hamster/TubeCube/TubeCube.pdf

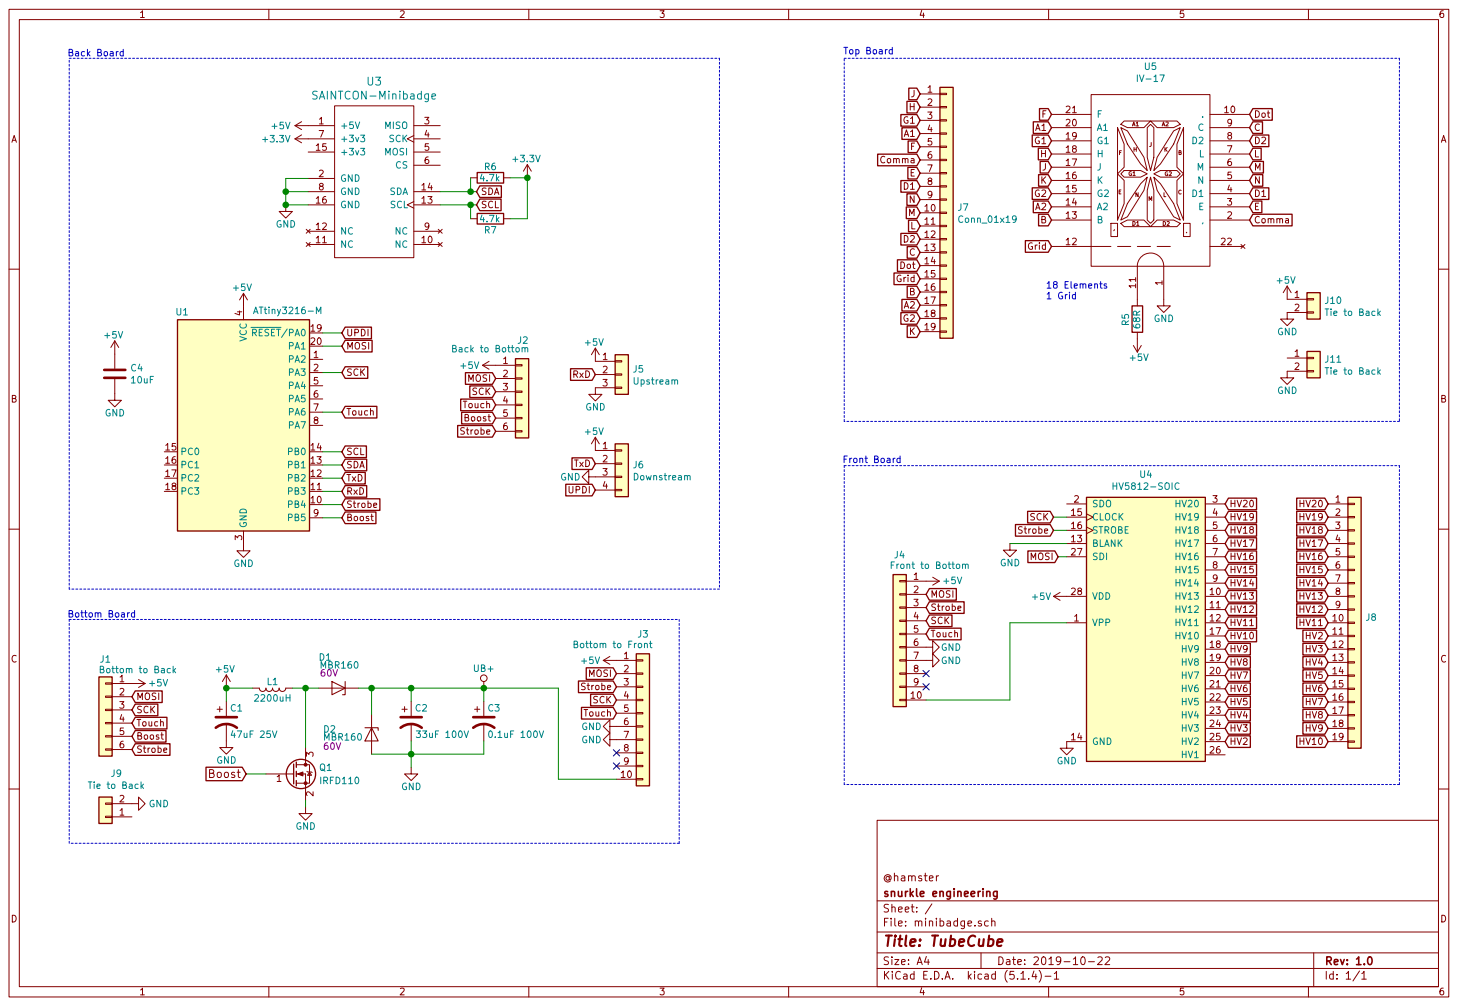
[picture p3: page 1]

18 Elements 1 Grid Back Board

J7Conn_01x19 GND GND GND GND 12

Front Board Bottom Board

@hamster
File: minibadge.sch Sheet: / snurkle engineering
