hamster/TubeCube/Software/TubeCube/TubeCube/src/driver_init.c

/**
 * \file
 *
 * \brief Driver initialization.
 *
 (c) 2018 Microchip Technology Inc. and its subsidiaries.

    Subject to your compliance with these terms,you may use this software and
    any derivatives exclusively with Microchip products.It is your responsibility
    to comply with third party license terms applicable to your use of third party
    software (including open source software) that may accompany Microchip software.

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
    IN NO EVENT WILL MICROCHIP BE LIABLE FOR ANY INDIRECT, SPECIAL, PUNITIVE,
    INCIDENTAL OR CONSEQUENTIAL LOSS, DAMAGE, COST OR EXPENSE OF ANY KIND
    WHATSOEVER RELATED TO THE SOFTWARE, HOWEVER CAUSED, EVEN IF MICROCHIP HAS
    BEEN ADVISED OF THE POSSIBILITY OR THE DAMAGES ARE FORESEEABLE. TO THE
    FULLEST EXTENT ALLOWED BY LAW, MICROCHIP'S TOTAL LIABILITY ON ALL CLAIMS IN
    ANY WAY RELATED TO THIS SOFTWARE WILL NOT EXCEED THE AMOUNT OF FEES, IF ANY,
    THAT YOU HAVE PAID DIRECTLY TO MICROCHIP FOR THIS SOFTWARE.
 *
 */

/*
 * Code generated by START.
 *
 * This file will be overwritten when reconfiguring your START project.
 * Please copy examples or other code you want to keep to a separate file
 * to avoid losing it when reconfiguring.
 */

#include "driver_init.h"
#include <system.h>

/* configure the pins and initialize the registers */
void USART_0_initialization(void)
{

	// Set pin direction to input
	PB3_set_dir(PORT_DIR_IN);

	PB3_set_pull_mode(
	    // <y> Pull configuration
	    // <id> pad_pull_config
	    // <PORT_PULL_OFF"> Off
	    // <PORT_PULL_UP"> Pull-up
	    PORT_PULL_OFF);

	// Set pin direction to output
	PB2_set_dir(PORT_DIR_OUT);

	PB2_set_level(
	    // <y> Initial level
	    // <id> pad_initial_level
	    // <false"> Low
	    // <true"> High
	    false);

	USART_0_init();
}

void PWM_0_initialization(void)
{

	// Set pin direction to output
	Boost_set_dir(PORT_DIR_OUT);

	Boost_set_level(
	    // <y> Initial level
	    // <id> pad_initial_level
	    // <false"> Low
	    // <true"> High
	    false);

	/* set the alternate pin mux */
	PORTMUX.CTRLC |= PORTMUX_TCA02_bm;

	PWM_0_init();
}

/* configure the pins and initialize the registers */
void SPI_0_initialization(void)
{

	// Set pin direction to input
	PA2_set_dir(PORT_DIR_IN);

	PA2_set_pull_mode(
	    // <y> Pull configuration
	    // <id> pad_pull_config
	    // <PORT_PULL_OFF"> Off
	    // <PORT_PULL_UP"> Pull-up
	    PORT_PULL_OFF);

	// Set pin direction to output
	PA1_set_dir(PORT_DIR_OUT);

	PA1_set_level(
	    // <y> Initial level
	    // <id> pad_initial_level
	    // <false"> Low
	    // <true"> High
	    false);

	// Set pin direction to output
	PA3_set_dir(PORT_DIR_OUT);

	PA3_set_level(
	    // <y> Initial level
	    // <id> pad_initial_level
	    // <false"> Low
	    // <true"> High
	    false);

	SPI_0_init();
}

/* configure pins and initialize registers */
void I2C_0_initialization(void)
{

	PB0_set_dir(
	    // <y> Pin direction
	    // <id> pad_dir
	    // <PORT_DIR_OFF"> Off
	    // <PORT_DIR_IN"> In
	    // <PORT_DIR_OUT"> Out
	    PORT_DIR_OUT);

	PB0_set_level(
	    // <y> Initial level
	    // <id> pad_initial_level
	    // <false"> Low
	    // <true"> High
	    false);

	PB0_set_pull_mode(
	    // <y> Pull configuration
	    // <id> pad_pull_config
	    // <PORT_PULL_OFF"> Off
	    // <PORT_PULL_UP"> Pull-up
	    PORT_PULL_OFF);

	PB0_set_inverted(
	    // <y> Invert I/O on pin
	    // <id> pad_invert
	    // <false"> Not inverted
	    // <true"> Inverted
	    false);

	PB0_set_isc(
	    // <y> Pin Input/Sense Configuration
	    // <id> pad_isc
	    // <PORT_ISC_INTDISABLE_gc"> Interrupt disabled but input buffer enabled
	    // <PORT_ISC_BOTHEDGES_gc"> Sense Both Edges
	    // <PORT_ISC_RISING_gc"> Sense Rising Edge
	    // <PORT_ISC_FALLING_gc"> Sense Falling Edge
	    // <PORT_ISC_INPUT_DISABLE_gc"> Digital Input Buffer disabled
	    // <PORT_ISC_LEVEL_gc"> Sense low Level
	    PORT_ISC_INTDISABLE_gc);

	PB1_set_dir(
	    // <y> Pin direction
	    // <id> pad_dir
	    // <PORT_DIR_OFF"> Off
	    // <PORT_DIR_IN"> In
	    // <PORT_DIR_OUT"> Out
	    PORT_DIR_OUT);

	PB1_set_level(
	    // <y> Initial level
	    // <id> pad_initial_level
	    // <false"> Low
	    // <true"> High
	    false);

	PB1_set_pull_mode(
	    // <y> Pull configuration
	    // <id> pad_pull_config
	    // <PORT_PULL_OFF"> Off
	    // <PORT_PULL_UP"> Pull-up
	    PORT_PULL_OFF);

	PB1_set_inverted(
	    // <y> Invert I/O on pin
	    // <id> pad_invert
	    // <false"> Not inverted
	    // <true"> Inverted
	    false);

	PB1_set_isc(
	    // <y> Pin Input/Sense Configuration
	    // <id> pad_isc
	    // <PORT_ISC_INTDISABLE_gc"> Interrupt disabled but input buffer enabled
	    // <PORT_ISC_BOTHEDGES_gc"> Sense Both Edges
	    // <PORT_ISC_RISING_gc"> Sense Rising Edge
	    // <PORT_ISC_FALLING_gc"> Sense Falling Edge
	    // <PORT_ISC_INPUT_DISABLE_gc"> Digital Input Buffer disabled
	    // <PORT_ISC_LEVEL_gc"> Sense low Level
	    PORT_ISC_INTDISABLE_gc);

	I2C_0_init();
}

/**
 * \brief System initialization
 */
void system_init()
{
	mcu_init();

	/* PORT setting on PB4 */

	// Set pin direction to output
	Strobe_set_dir(PORT_DIR_OUT);

	Strobe_set_level(
	    // <y> Initial level
	    // <id> pad_initial_level
	    // <false"> Low
	    // <true"> High
	    false);

	CLKCTRL_init();

	USART_0_initialization();

	PWM_0_initialization();

	SPI_0_initialization();

	CPUINT_init();

	SLPCTRL_init();

	I2C_0_initialization();

	BOD_init();
}
