hamster/TubeCube/Software/TubeCube/TubeCube/characters.h

/*
 *  Project     Segmented LED Display - ASCII Library
 *  @author     David Madison
 *  @link       github.com/dmadison/Segmented-LED-Display-ASCII
 *  @license    MIT - Copyright (c) 2017 David Madison
 *
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
 */


#ifndef CHARACTERS_H_
#define CHARACTERS_H_

const uint8_t TubeChar[][3] = {
 { 0b00000000, 0b00000000, 0b00000000 }, //  (space)
 { 0b00000000, 0b00000000, 0b01011000 }, //  !
 { 0b00001000, 0b00000000, 0b01000000 }, //  "
 { 0b00001010, 0b00010101, 0b01001100 }, //  #
 { 0b00001011, 0b10010101, 0b10001100 }, //  $
 { 0b00001011, 0b10001111, 0b00001100 }, //  %
 { 0b00001111, 0b00110000, 0b00000110 }, //  &
 { 0b00001000, 0b00000000, 0b00000000 }, //  '
 { 0b00000000, 0b00000010, 0b00000010 }, //  (
 { 0b00000100, 0b00001000, 0b00000000 }, //  )
 { 0b00001110, 0b00001111, 0b00000010 }, //  *
 { 0b00001010, 0b00000101, 0b00000000 }, //  +
 { 0b00000000, 0b01000000, 0b00000000 }, //  ,
 { 0b00000010, 0b00000001, 0b00000000 }, //  -
 { 0b00000000, 0b00000000, 0b00010000 }, //  .
 { 0b00000000, 0b00001010, 0b00000000 }, //  /
 { 0b00000001, 0b10111010, 0b11001100 }, //  0
 { 0b00000000, 0b00000010, 0b01001000 }, //  1
 { 0b00000011, 0b00110001, 0b11000100 }, //  2
 { 0b00000001, 0b00010001, 0b11001100 }, //  3
 { 0b00000010, 0b10000001, 0b01001000 }, //  4
 { 0b00000011, 0b10010000, 0b10000110 }, //  5
 { 0b00000011, 0b10110001, 0b10001100 }, //  6
 { 0b00000001, 0b00000000, 0b11001000 }, //  7
 { 0b00000011, 0b10110001, 0b11001100 }, //  8
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
	{ 0b00000000, 0b00000000, 0b00001000 }, // C
	{ 0b00000000, 0b00000000, 0b00000100 }, // D2
	{ 0b00000000, 0b00010000, 0b00000000 }, // D1
	{ 0b00000000, 0b00100000, 0b00000000 }, // E
	{ 0b00000000, 0b10000000, 0b00000000 } // F
};

#endif /* CHARACTERS_H_ */
